Bonoy0328/toothBox/Doc/用户手册/HC32L110管脚功能查询及配置.xlsx

Sheet: 管脚功能查询
 | 筛选条件1 | UART0 | 修改左侧的 筛选条件以 高亮不同的功能 | 筛选条件4 | VCIN0 | 修改左侧的 筛选条件以 高亮不同的功能
 | 筛选条件2 | I2C |  | 筛选条件5 | AIN1
 | 筛选条件3 | LPTIM |  | 筛选条件6 | TIM2
数字功能 |  |  |  |  |  |  |  |  | 模拟功能
Pxx_SEL = 0 | Pxx_SEL = 1 | Pxx_SEL = 2 | Pxx_SEL = 3 | Pxx_SEL = 4 | Pxx_SEL = 5 | Pxx_SEL = 6 | Pxx_SEL = 7
P01 | UART0_RXD | I2C_SDA | UART1_TXD | TIM0_TOG | TIM5_CHB | SPI_SCK | TIM2_EXT |  | XTHI | AIN7 | VCIN7
P02 | UART0_TXD | I2C_SCL | UART1_RXD | TIM0_TOGN | TIM6_CHA | SPI_CS | TIM2_GATE |  | XTHO | AIN8
P03 | PCA_CH3 | SPI_CS | TIM6_CHB | LPTIM_EXT | RTC_1Hz | PCA_ECI | VC0_OUT |  | LVDIN1
P14 | I2C_SCL | TIM2_TOGN | PCA_ECI | ADC_RDY | SPI_CS | UART0_TXD | NC |  | XTLI
P15 | I2C_SDA | TIM2_TOG | TIM4_CHB | LPTIM_GATE | SPI_SCK | UART0_RXD | LVD_OUT |  | XTLO
P23 | TIM6_CHA | TIM4_CHB | TIM4_CHA | PCA_CH0 | SPI_MISO | UART1_TXD | IR_OUT |  | LVDIN2 | VCIN0
P24 | TIM4_CHB | TIM5_CHB | HCLK_OUT | PCA_CH1 | SPI_MOSI | UART1_RXD | VC1_OUT |  | AIN0
P25 | SPI_SCK | PCA_CH0 | TIM5_CHA | LVD_OUT | LPUART_RXD | I2C_SDA | TIM1_GATE |  | LVDIN3 | VCIN1
P26 | SPI_MOSI | TIM4_CHA | TIM5_CHB | PCA_CH2 | LPUART_TXD | I2C_SCL | TIM1_EXT |  | AIN1
P27/SWDIO | SPI_MISO | TIM5_CHA | TIM6_CHA | PCA_CH3 | UART0_RXD | RCH_OUT | XTH_OUT
P31/SWCLK | LPTIM_TOG | PCA_ECI | PCLK_OUT | VC0_OUT | UART0_TXD | RCL_OUT | HCLK_OUT
P32 | LPTIM_TOGN | PCA_CH2 | TIM6_CHB | VC1_OUT | UART1_TXD | PCA_CH4 | RTC_1Hz |  | AIN2 | VCIN2
P33 | LPUART_RXD | PCA_CH1 | TIM5_CHB | PCA_ECI | UART1_RXD | XTL_OUT | TIM1_TOGN |  | AIN3 | VCIN3
P34 | PCA_CH0 | LPUART_TXD | TIM5_CHA | TIM0_EXT | TIM4_CHA | RTC_1Hz | TIM1_TOG |  | AIN4 | VCIN4
P35 | UART1_TXD | TIM6_CHB | UART0_TXD | TIM0_GATE | TIM4_CHB | SPI_MISO | I2C_SDA |  | AIN5 | VCIN5
P36 | UART1_RXD | TIM6_CHA | UART0_RXD | PCA_CH4 | TIM5_CHA | SPI_MOSI | I2C_SCL |  | AIN6 | VCIN6 | ADC_VREF
AIN4 | AIN5 | AIN6 | AIN7 | AIN8 | LVDIN1 | XTLO | XTLI | LVDIN2 | AIN0 | LVDIN3 | AIN1 |  |  | AIN2 | AIN3
VCIN4 | VCIN5 | ADC_VREF | XTHI | XTHO |  |  |  | VCIN0 |  | VCIN1 |  |  |  | VCIN2 | VCIN3
 |  | VCIN6 | VCIN7
P34 | P35 | P36 | P01 | P02 | P03 | P15 | P14 | P23 | P24 | P25 | P26 | P27/SWDIO | P31/SWCLK | P32 | P33
PCA_CH0 | UART1_TXD | UART1_RXD | UART0_RXD | UART0_TXD | PCA_CH3 | I2C_SDA | I2C_SCL | TIM6_CHA | TIM4_CHB | SPI_SCK | SPI_MOSI | SPI_MISO | LPTIM_TOG | LPTIM_TOGN | LPUART_RXD
LPUART_TXD | TIM6_CHB | TIM6_CHA | I2C_SDA | I2C_SCL | SPI_CS | TIM2_TOG | TIM2_TOGN | TIM4_CHB | TIM5_CHB | PCA_CH0 | TIM4_CHA | TIM5_CHA | PCA_ECI | PCA_CH2 | PCA_CH1
TIM5_CHA | UART0_TXD | UART0_RXD | UART1_TXD | UART1_RXD | TIM6_CHB | TIM4_CHB | PCA_ECI | TIM4_CHA | HCLK_OUT | TIM5_CHA | TIM5_CHB | TIM6_CHA | PCLK_OUT | TIM6_CHB | TIM5_CHB
TIM0_EXT | TIM0_GATE | PCA_CH4 | TIM0_TOG | TIM0_TOGN | LPTIM_EXT | LPTIM_GATE | ADC_RDY | PCA_CH0 | PCA_CH1 | LVD_OUT | PCA_CH2 | PCA_CH3 | VC0_OUT | VC1_OUT | PCA_ECI
TIM4_CHA | TIM4_CHB | TIM5_CHA | TIM5_CHB | TIM6_CHA | RTC_1Hz | SPI_SCK | SPI_CS | SPI_MISO | SPI_MOSI | LPUART_RXD | LPUART_TXD | UART0_RXD | UART0_TXD | UART1_TXD | UART1_RXD
RTC_1Hz | SPI_MISO | SPI_MOSI | SPI_SCK | SPI_CS | PCA_ECI | UART0_RXD | UART0_TXD | UART1_TXD | UART1_RXD | I2C_SDA | I2C_SCL | RCH_OUT | RCL_OUT | PCA_CH4 | XTL_OUT
TIM1_TOG | I2C_SDA | I2C_SCL | TIM2_EXT | TIM2_GATE | VC0_OUT | LVD_OUT | NC | IR_OUT | VC1_OUT | TIM1_GATE | TIM1_EXT | XTH_OUT | HCLK_OUT | RTC_1Hz | TIM1_TOGN

Sheet: 管脚功能配置
管脚名称 | 管脚功能 | 输入输出 | 输出类型 | 输出初值 | 上拉下拉 | 管脚初始化源码
P01 | GPIO | 输入 | 推挽 | 0 | 上拉 | M0P_GPIO->P0ADS = 0x0000; | M0P_GPIO->P2ADS = 0x0000;
P02 | GPIO | 输入 | 推挽 | 0 | 上拉 | M0P_GPIO->P0PU = 0x000E; | M0P_GPIO->P2PU = 0x00F8;
P03 | GPIO | 输入 | 推挽 | 0 | 上拉 | M0P_GPIO->P0PD = 0x0000; | M0P_GPIO->P2PD = 0x0000;
P14 | GPIO | 输入 | 推挽 | 0 | 上拉 | M0P_GPIO->P0OD = 0x0000; | M0P_GPIO->P2OD = 0x0000;
P15 | GPIO | 输入 | 推挽 | 0 | 上拉 | M0P_GPIO->P0OUT = 0x0000; | M0P_GPIO->P2OUT = 0x0000;
P23 | GPIO | 输入 | 推挽 | 0 | 上拉 | M0P_GPIO->P0DIR = 0x000E; | M0P_GPIO->P2DIR = 0x00F8;
P24 | GPIO | 输入 | 推挽 | 0 | 上拉 | //P01 = GPIO | //P23 = GPIO
P25 | GPIO | 输入 | 推挽 | 0 | 上拉 | //P02 = GPIO | //P24 = GPIO
P26 | GPIO | 输入 | 推挽 | 0 | 上拉 | //P03 = GPIO | //P25 = GPIO
P27 | SWDIO | NA | NA | NA | 上拉 |  | //P26 = GPIO
P31 | SWDCK | NA | NA | NA | 上拉 |  | //P27 = GPIO
P32 | GPIO | 输入 | 推挽 | 0 | 上拉
P33 | GPIO | 输入 | 推挽 | 0 | 上拉 | M0P_GPIO->P1ADS = 0x0000; | M0P_GPIO->P3ADS = 0x0000;
P34 | GPIO | 输入 | 推挽 | 0 | 上拉 | M0P_GPIO->P1PU = 0x0030; | M0P_GPIO->P3PU = 0x007E;
P35 | GPIO | 输入 | 推挽 | 0 | 上拉 | M0P_GPIO->P1PD = 0x0000; | M0P_GPIO->P3PD = 0x0000;
P36 | GPIO | 输入 | 推挽 | 0 | 上拉 | M0P_GPIO->P1OD = 0x0000; | M0P_GPIO->P3OD = 0x0000;
 |  |  |  |  |  | M0P_GPIO->P1OUT = 0x0000; | M0P_GPIO->P3OUT = 0x0000;
 |  |  |  |  |  | M0P_GPIO->P1DIR = 0x0030; | M0P_GPIO->P3DIR = 0x007E;
 |  |  |  |  |  | //P14 = GPIO | //P31 = GPIO
 |  |  |  |  |  | //P15 = GPIO | //P32 = GPIO
 |  |  |  |  |  |  | //P33 = GPIO
 |  |  |  |  |  |  | //P34 = GPIO
 |  |  |  |  |  |  | //P35 = GPIO
 |  |  |  |  |  |  | //P36 = GPIO
