Bonoy0328/toothBox/(list of files, drawings)

Other design files:
Hal/toothpickBox(1).~(4).SchDoc
