Bonoy0328/toothBox/Prj/driver/inc/gpio.h

/*******************************************************************************
* Copyright (C) 2017, Huada Semiconductor Co.,Ltd All rights reserved.
*
* This software is owned and published by:
* Huada Semiconductor Co.,Ltd ("HDSC").
*
* BY DOWNLOADING, INSTALLING OR USING THIS SOFTWARE, YOU AGREE TO BE BOUND
* BY ALL THE TERMS AND CONDITIONS OF THIS AGREEMENT.
*
* This software contains source code for use with HDSC
* components. This software is licensed by HDSC to be adapted only
* for use in systems utilizing HDSC components. HDSC shall not be
* responsible for misuse or illegal use of this software for devices not
* supported herein. HDSC is providing this software "AS IS" and will
* not be responsible for issues arising from incorrect user implementation
* of the software.
*
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
* This software may be replicated in part or whole for the licensed use,
* with the restriction that this Disclaimer and Copyright notice must be
* included with each copy of this software, whether used in part or whole,
* at all times.
*/
/******************************************************************************/
/** \file gpio.h
 **
 ** GPIO driver
 ** @link GPIO Group Some description @endlink
 **
 **   - 2017-05-04
 **
 ******************************************************************************/

#ifndef __GPIO_H__
#define __GPIO_H__

/*******************************************************************************
 * Include files
 ******************************************************************************/
#include "ddl.h"
#include "interrupts_hc32l110.h"

/* C binding of definitions if building with C++ compiler */
#ifdef __cplusplus
extern "C"
{
#endif

/**
 *******************************************************************************
 ** \defgroup GpioGroup General Purpose I/O (GPIO)
 **
 **
 ******************************************************************************/
//@{
#define GPIO_GPSZ       (0x40u)

/*******************************************************************************
 * Global type definitions
 ******************************************************************************/

/**
 *******************************************************************************
 ** \brief GPIO输入输出方向
 ******************************************************************************/
typedef enum en_gpio_dir
{
    GpioDirOut,                 ///< GPIO 输出
    GpioDirIn,                  ///< GPIO 输入
}en_gpio_dir_t;


/**
 *******************************************************************************
 ** \brief GPIO中断触发方式
 ******************************************************************************/
typedef enum en_gpio_irqtype
{
    GpioIrqHigh     = 1 << 0,   ///< GPIO高电平触发
    GpioIrqLow      = 1 << 1,   ///< GPIO低电平触发
    GpioIrqRising   = 1 << 2,   ///< GPIO上升沿触发
    GpioIrqFalling  = 1 << 3,   ///< GPIO下降沿触发
}en_gpio_irqtype_t;

/**
 *******************************************************************************
 ** \brief GPIO附加功能
 ******************************************************************************/
typedef enum en_gpio_ctrlext
{
    GpioCtrlIESEL,              ///< >0:    deep sleep
                                ///< =0:    active sleep
    GpioCtrlIRPOL,              ///< >0:    reverse output
                                ///< =0:    normal output
    GpioCtrlHclkEn,             ///< >0:    output enable
                                ///< =0     output disable
    GpioCtrlPclkEn,             ///< >0:    output enable
                                ///< =0     output disable
    GpioCtrlHclkSel,            ///< div value
    GpioCtrlPclkSel,            ///< div value
}en_gpio_ctrlext_t;

/**
 *******************************************************************************
 ** \brief GPIO SSN 信号源枚举
 ******************************************************************************/
typedef enum en_gpio_ctrl1src
{
    GpioCtrl1SrcP35 = 0x1,      ///< P35
    GpioCtrl1SrcP36 = 0x2,      ///< P36
    GpioCtrl1SrcP01 = 0x3,      ///< P01
    GpioCtrl1SrcP02 = 0x4,      ///< P02
    GpioCtrl1SrcP03 = 0x5,      ///< P03
    GpioCtrl1SrcP15 = 0x6,      ///< P15
    GpioCtrl1SrcP14 = 0x7,      ///< P14
    GpioCtrl1SrcP23 = 0x8,      ///< P23
    GpioCtrl1SrcP24 = 0x9,      ///< P24
    GpioCtrl1SrcP25 = 0xA,      ///< P25
    GpioCtrl1SrcP26 = 0xB,      ///< P26
    GpioCtrl1SrcP27 = 0xC,      ///< P27
    GpioCtrl1SrcP31 = 0xD,      ///< P31
    GpioCtrl1SrcP32 = 0xE,      ///< P32
    GpioCtrl1SrcP33 = 0xF,      ///< P33

}en_gpio_ctrl1src_t;


/**
 *******************************************************************************
 ** \brief GPIO PCA 捕获通道x信号来源选择
 ******************************************************************************/
typedef enum en_gpio_target
{
    GpioSignalCAP4,     ///< CAP4
    GpioSignalCAP3,     ///< CAP3
    GpioSignalCAP2,     ///< CAP2
    GpioSignalCAP1,     ///< CAP1
    GpioSignalCAP0,     ///< CAP0
    GpioSignalTm6A,     ///< Tm6A
    GpioSignalTm5A,     ///< Tm5A
    GpioSignalTm4A,     ///< Tm4A
    GpioSignalTm6B,     ///< Tm6B
    GpioSignalTm5B,     ///< Tm5B
    GpioSignalTm4B,     ///< Tm4B
    GpioSignalTm3,      ///< Tm3
    GpioSignalTm2,      ///< Tm2
    GpioSignalTm1,      ///< Tm1
    GpioSignalTm0,      ///< Tm0
}en_gpio_target_t;

/**
 *******************************************************************************
 ** \brief GPIO Timer信号来源选择
 ******************************************************************************/
typedef enum en_gpio_timex_in
{
    GpioTMxIn = 0,          ///< TMx
    GpioPcaCapxIn = 0,      ///< PcaCapx
    GpioUart0RxdIn = 1,     ///< Uart0Rxd
    GpioUart1RxdIn = 2,     ///< Uart1Rxd
    GpioUart2RxdIn = 3,     ///< Uart2Rxd
}en_gpio_timex_in_t;


/*******************************************************************************
 * Global definitions
 ******************************************************************************/

///< GPIO 模拟功能选择
en_result_t Gpio_SetAnalog(uint8_t u8Port, uint8_t u8Pin, boolean_t bFlag);

///< GPIO IO功能初始化
en_result_t Gpio_InitIO(uint8_t u8Port, uint8_t u8Pin,
                        en_gpio_dir_t enDir);

en_result_t Gpio_InitIOExt(uint8_t u8Port, uint8_t u8Pin,
                        en_gpio_dir_t enDir,
                        boolean_t bPullup,
                        boolean_t bPulldown,
                        boolean_t bOdr,
                        boolean_t bDrive);

///< GPIO IO输出输入电平
void Gpio_SetIO(uint8_t u8Port, uint8_t u8Pin,boolean_t bVal);
boolean_t Gpio_GetIO(uint8_t u8Port, uint8_t u8Pin);

///< GPIO 中断控制使能
en_result_t Gpio_EnableIrq(uint8_t u8Port,
                           uint8_t u8Pin,
                           en_gpio_irqtype_t enType);

en_result_t Gpio_DisableIrq(uint8_t u8Port,
                            uint8_t u8Pin,
                            en_gpio_irqtype_t enType);

boolean_t Gpio_GetIrqStat(uint8_t u8Port,uint8_t u8Pin);
en_result_t Gpio_ClearIrq(uint8_t u8Port,uint8_t u8Pin);

///< GPIO 附加功能函数
en_result_t Gpio_SetCtrlExt(en_gpio_ctrlext_t enFunc, uint8_t u8val);
en_result_t Gpio_SetSsnSel(en_gpio_ctrl1src_t enSrc);
en_result_t Gpio_SetExtClkSel(en_gpio_ctrl1src_t enSrc);
en_result_t Gpio_SetSignalSource(en_gpio_target_t enTarget, en_gpio_timex_in_t enType);

/*
    GPIO PIN功能配置设置宏定义
*/
#define Gpio_SetFunc_UART0_RXD_P01()          do{\
                                                M0P_GPIO->P0ADS_f.P01 = 0;\
                                                M0P_GPIO->P01_SEL_f.SEL = 1;\
                                                M0P_GPIO->P0DIR_f.P01 = 1;\
                                            }while(0);

#define Gpio_SetFunc_I2C_SDA_P01()           do{\
                                                M0P_GPIO->P0ADS_f.P01 = 0;\
                                                M0P_GPIO->P01_SEL_f.SEL = 2;\
                                                M0P_GPIO->P0DIR_f.P01 = 0;\
                                            }while(0);

#define Gpio_SetFunc_UART1_TXD_P01()          do{\
                                                M0P_GPIO->P0ADS_f.P01 = 0;\
                                                M0P_GPIO->P01_SEL_f.SEL = 3;\
                                                M0P_GPIO->P0DIR_f.P01 = 0;\
                                            }while(0);

#define Gpio_SetFunc_TIM0_TOG_P01()        do{\
                                                M0P_GPIO->P0ADS_f.P01 = 0;\
                                                M0P_GPIO->P01_SEL_f.SEL = 4;\
                                                M0P_GPIO->P0DIR_f.P01 = 0;\
                                            }while(0);

#define Gpio_SetFunc_TIM5_CHB_P01()              do{\
                                                M0P_GPIO->P0ADS_f.P01 = 0;\
                                                M0P_GPIO->P01_SEL_f.SEL = 5;\
                                                M0P_GPIO->P0DIR_f.P01 = 0;\
                                            }while(0);

#define Gpio_SetFunc_SPI_SCK_P01()           do{\
                                                M0P_GPIO->P0ADS_f.P01 = 0;\
                                                M0P_GPIO->P01_SEL_f.SEL = 6;\
                                                M0P_GPIO->P0DIR_f.P01 = 0;\
                                            }while(0);

#define Gpio_SetFunc_TIM2_EXT_P01()             do{\
                                                M0P_GPIO->P0ADS_f.P01 = 0;\
                                                M0P_GPIO->P01_SEL_f.SEL = 7;\
                                                M0P_GPIO->P0DIR_f.P01 = 1;\
                                            }while(0);

#define Gpio_SetFunc_UART0_TXD_P02()          do{\
                                                M0P_GPIO->P0ADS_f.P02 = 0;\
                                                M0P_GPIO->P02_SEL_f.SEL = 1;\
                                                M0P_GPIO->P0DIR_f.P02 = 0;\
                                            }while(0);

#define Gpio_SetFunc_I2C_SCL_P02()           do{\
                                                M0P_GPIO->P0ADS_f.P02 = 0;\
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
 ******************************************************************************/

/******************************************************************************
 * Global variable definitions ('extern')
 ******************************************************************************/

/******************************************************************************
  Global function prototypes (definition in C source)
*******************************************************************************/


//@} // GpioGroup

#ifdef __cplusplus
}
#endif

#endif /* __GPIO_H__ */
/******************************************************************************
 * EOF (not truncated)
 ******************************************************************************/
