Bonoy0328/toothBox/Prj/driver/src/bt.c

/******************************************************************************
*Copyright(C)2017, Huada Semiconductor Co.,Ltd All rights reserved.
*
* This software is owned and published by:
* Huada Semiconductor Co.,Ltd("HDSC").
*
* BY DOWNLOADING, INSTALLING OR USING THIS SOFTWARE, YOU AGREE TO BE BOUND
* BY ALL THE TERMS AND CONDITIONS OF THIS AGREEMENT.
*
* This software contains source code for use with HDSC
* components. This software is licensed by HDSC to be adapted only
* for use in systems utilizing HDSC components. HDSC shall not be
* responsible for misuse or illegal use of this software for devices not
* supported herein. HDSC is providing this software "AS IS" and will
* not be responsible for issues arising from incorrect user implementation
* of the software.
*
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
* This software may be replicated in part or whole for the licensed use,
* with the restriction that this Disclaimer and Copyright notice must be
* included with each copy of this software, whether used in part or whole,
* at all times.
*/

/** \file bt.c
 **
 ** Common API of base timer.
 ** @link btGroup Some description @endlink
 **
 **   - 2017-05-16
 **
 ******************************************************************************/

/*******************************************************************************
 * Include files
 ******************************************************************************/
#include "bt.h"
/**
 *******************************************************************************
 ** \addtogroup BtGroup
 ******************************************************************************/
//@{

/*******************************************************************************
 * Local pre-processor symbols/macros ('#define')
 ******************************************************************************/
#define IS_VALID_TIM(x)         (TIM0 == (x) ||\
                                 TIM1 == (x) ||\
                                 TIM2 == (x))

/*******************************************************************************
 * Global variable definitions (declared in header file with 'extern')
 ******************************************************************************/

/*******************************************************************************
 * Local type definitions ('typedef')
 ******************************************************************************/

/*******************************************************************************
 * Local variable definitions ('static')
 ******************************************************************************/
static func_ptr_t pfnTim0Callback = NULL;
static func_ptr_t pfnTim1Callback = NULL;
static func_ptr_t pfnTim2Callback = NULL;
/*******************************************************************************
 * Local function prototypes ('static')
 ******************************************************************************/


/*******************************************************************************
 * Function implementation - global ('extern') and local ('static')
 ******************************************************************************/
/**
 *****************************************************************************
 ** \brief Base Timer 中断标志获取
 **
 **
 ** \param [in]  enUnit           Timer通道选择（TIM0、TIM1、TIM2）
 ** 
 ** \retval TRUE or FALSE                                      
 *****************************************************************************/
boolean_t Bt_GetIntFlag(en_bt_unit_t enUnit)
{
    boolean_t bRetVal = FALSE;
  
    ASSERT(IS_VALID_TIM(enUnit));
    
    switch (enUnit)
    {
        case TIM0:
            bRetVal = M0P_BT0->IFR_f.TF ? TRUE : FALSE;
            break;
        case TIM1:
            bRetVal = M0P_BT1->IFR_f.TF ? TRUE : FALSE;
            break;
        case TIM2:
            bRetVal = M0P_BT2->IFR_f.TF ? TRUE : FALSE;
            break;
        default:
            bRetVal = FALSE;
            break;
    }
    
    return bRetVal;
}

/**
 *****************************************************************************
 ** \brief Base Timer 中断标志清除
 **
 **
 ** \param [in]  enUnit           Timer通道选择（TIM0、TIM1、TIM2）
 ** 
 ** \retval Ok or Error                                      
 *****************************************************************************/
en_result_t Bt_ClearIntFlag(en_bt_unit_t enUnit)
{
    en_result_t enResult = Ok;
  
    ASSERT(IS_VALID_TIM(enUnit));
    
    switch (enUnit)
    {
        case TIM0:
            M0P_BT0->ICLR_f.TFC = FALSE;
            break;
        case TIM1:
            M0P_BT1->ICLR_f.TFC = FALSE;;
            break;
        case TIM2:
            M0P_BT2->ICLR_f.TFC = FALSE;;
            break;
        default:
            enResult = Error;
            break;
    }
    
    return enResult;
}

/**
 *****************************************************************************
 ** \brief Base Timer 中断使能
 **
 **
 ** \param [in]  enUnit           Timer通道选择（TIM0、TIM1、TIM2）
 ** 
 ** \retval Ok or Error                                      
 *****************************************************************************/
en_result_t Bt_EnableIrq (en_bt_unit_t enUnit)
{
    en_result_t enResult = Ok;
  
    ASSERT(IS_VALID_TIM(enUnit));
    
    switch (enUnit)
    {
        case TIM0:
            M0P_BT0->CR_f.IE = TRUE;
            break;
        case TIM1:
            M0P_BT1->CR_f.IE = TRUE;
            break;
        case TIM2:
            M0P_BT2->CR_f.IE = TRUE;
            break;
        default:
            enResult = Error;
            break;
    }
    
    return enResult;
}

/**
 *****************************************************************************
 ** \brief Base Timer 中断禁止
 **
 **
 ** \param [in]  enUnit           Timer通道选择（TIM0、TIM1、TIM2）
 ** 
 ** \retval Ok or Error                                      
 *****************************************************************************/
en_result_t Bt_DisableIrq(en_bt_unit_t enUnit)
{
    en_result_t enResult = Ok;
  
    ASSERT(IS_VALID_TIM(enUnit));
    
    switch (enUnit)
    {
        case TIM0:
            M0P_BT0->CR_f.IE = FALSE;
            break;
        case TIM1:
            M0P_BT1->CR_f.IE = FALSE;
            break;
        case TIM2:
            M0P_BT2->CR_f.IE = FALSE;
            break;
        default:
            enResult = Error;
            break;
    }
    
    return enResult;
}

/**
 *****************************************************************************
 ** \brief Base Timer 中断服务函数
 **
 **
 ** \param [in]  u8Param           Timer通道选择（0 - TIM0、1 - TIM1、2 - TIM2）
 ** 
 ** \retval NULL                                     
 *****************************************************************************/
void Tim_IRQHandler(uint8_t u8Param)
{  
    switch (u8Param)
    {
        case 0:
            pfnTim0Callback();
            break;
        case 1:
            pfnTim1Callback();
            break;
        case 2:
            pfnTim2Callback();
            break;
        default:
            ;
            break;       
    }
}



/**
 *****************************************************************************
 ** \brief Base Timer 初始化配置
 **
 **
 ** \param [in]  enUnit           Timer通道选择（TIM0、TIM1、TIM2）
 ** \param [in]  pstcConfig       初始化配置结构体指针
 ** 
 ** \retval Ok or Error                                      
 *****************************************************************************/
en_result_t Bt_Init(en_bt_unit_t enUnit, stc_bt_config_t* pstcConfig)
{
    en_result_t enResult = Ok;
  
    ASSERT(IS_VALID_TIM(enUnit));
    
    switch (enUnit)
    {
        case TIM0:
            {
                M0P_BT0->CR_f.GATE_P = pstcConfig->enGateP;
                M0P_BT0->CR_f.GATE   = pstcConfig->enGate;
                M0P_BT0->CR_f.PRS    = pstcConfig->enPRS;
                M0P_BT0->CR_f.TOG_EN = pstcConfig->enTog;
                M0P_BT0->CR_f.CT     = pstcConfig->enCT;
                M0P_BT0->CR_f.MD     = pstcConfig->enMD; 
                
                pfnTim0Callback      = pstcConfig->pfnTim0Cb;
            }
            break;
        case TIM1:
            {
                M0P_BT1->CR_f.GATE_P = pstcConfig->enGateP;
                M0P_BT1->CR_f.GATE   = pstcConfig->enGate;
                M0P_BT1->CR_f.PRS    = pstcConfig->enPRS;
                M0P_BT1->CR_f.TOG_EN = pstcConfig->enTog;
                M0P_BT1->CR_f.CT     = pstcConfig->enCT;
                M0P_BT1->CR_f.MD     = pstcConfig->enMD;
                
                pfnTim1Callback      = pstcConfig->pfnTim1Cb;
            }
            break;
        case TIM2:
            {
                M0P_BT2->CR_f.GATE_P = pstcConfig->enGateP;
                M0P_BT2->CR_f.GATE   = pstcConfig->enGate;
                M0P_BT2->CR_f.PRS    = pstcConfig->enPRS;
                M0P_BT2->CR_f.TOG_EN = pstcConfig->enTog;
                M0P_BT2->CR_f.CT     = pstcConfig->enCT;
                M0P_BT2->CR_f.MD     = pstcConfig->enMD; 
                
                pfnTim2Callback      = pstcConfig->pfnTim2Cb;
            }
            break;
        default:
            enResult = Error;
            break;
    }
    
    return enResult;
}

/**
 *****************************************************************************
 ** \brief Base Timer 启动运行
 **
 **
 ** \param [in]  enUnit           Timer通道选择（TIM0、TIM1、TIM2）
 ** 
 ** \retval Ok or Error                                      
 *****************************************************************************/
en_result_t Bt_Run(en_bt_unit_t enUnit)
{
    en_result_t enResult = Ok;
  
    ASSERT(IS_VALID_TIM(enUnit));
    
    switch (enUnit)
    {
        case TIM0:
            M0P_BT0->CR_f.TR = TRUE;
            break;
        case TIM1:
            M0P_BT1->CR_f.TR = TRUE;
            break;
        case TIM2:
            M0P_BT2->CR_f.TR = TRUE;
            break;
        default:
            enResult = Error;
            break;
    }
    
    return enResult;    
}

/**
 *****************************************************************************
 ** \brief Base Timer 停止运行
 **
 **
 ** \param [in]  enUnit           Timer通道选择（TIM0、TIM1、TIM2）
 ** 
 ** \retval Ok or Error                                      
 *****************************************************************************/
en_result_t Bt_Stop(en_bt_unit_t enUnit)
{
    en_result_t enResult = Ok;
  
    ASSERT(IS_VALID_TIM(enUnit));
    
    switch (enUnit)
    {
        case TIM0:
            M0P_BT0->CR_f.TR = FALSE;
            break;
        case TIM1:
            M0P_BT1->CR_f.TR = FALSE;
            break;
        case TIM2:
            M0P_BT2->CR_f.TR = FALSE;
            break;
        default:
            enResult = Error;
            break;
    }
    
    return enResult; 
}

/**
 *****************************************************************************
 ** \brief Base Timer 重载值设置
 **
 **
 ** \param [in]  enUnit           Timer通道选择（TIM0、TIM1、TIM2）
 ** \param [in]  u16Data          16bits重载值
 ** 
 ** \retval Ok or Error                                      
 *****************************************************************************/
en_result_t Bt_ARRSet(en_bt_unit_t enUnit, uint16_t u16Data)
{
    en_result_t enResult = Ok;
  
    ASSERT(IS_VALID_TIM(enUnit));
    
    switch (enUnit)
    {
        case TIM0:
            M0P_BT0->ARR_f.ARR = u16Data;
            break;
        case TIM1:
            M0P_BT1->ARR_f.ARR = u16Data;
            break;
        case TIM2:
            M0P_BT2->ARR_f.ARR = u16Data;
            break;
        default:
            enResult = Error;
            break;
    }
    
    return enResult; 
}

/**
 *****************************************************************************
 ** \brief Base Timer 16位计数器初值设置
 **
 **
 ** \param [in]  enUnit           Timer通道选择（TIM0、TIM1、TIM2）
 ** \param [in]  u16Data          16位初值
 ** 
 ** \retval Ok or Error                                      
 *****************************************************************************/
en_result_t Bt_Cnt16Set(en_bt_unit_t enUnit, uint16_t u16Data)
{
    en_result_t enResult = Ok;
  
    ASSERT(IS_VALID_TIM(enUnit));
    
    switch (enUnit)
    {
        case TIM0:
            M0P_BT0->CNT_f.CNT = u16Data;
            break;
        case TIM1:
            M0P_BT1->CNT_f.CNT = u16Data;
            break;
        case TIM2:
            M0P_BT2->CNT_f.CNT = u16Data;
            break;
        default:
            enResult = Error;
            break;
    }
    
    return enResult; 
}

/**
 *****************************************************************************
 ** \brief Base Timer 16位计数值获取
 **
 **
 ** \param [in]  enUnit           Timer通道选择（TIM0、TIM1、TIM2）
 ** 
 ** \retval 16bits计数值                                      
 *****************************************************************************/
uint16_t Bt_Cnt16Get(en_bt_unit_t enUnit)
{
    uint16_t    u16CntData = 0;
  
    ASSERT(IS_VALID_TIM(enUnit));
    
    switch (enUnit)
    {
        case TIM0:
            u16CntData = M0P_BT0->CNT_f.CNT;
            break;
        case TIM1:
            u16CntData = M0P_BT1->CNT_f.CNT;
            break;
        case TIM2:
            u16CntData = M0P_BT2->CNT_f.CNT;
            break;
        default:
            u16CntData = 0;
            break;
    }
    
    return u16CntData; 
}

/**
 *****************************************************************************
 ** \brief Base Timer 32位计数器初值设置
 **
 **
 ** \param [in]  enUnit           Timer通道选择（TIM0、TIM1、TIM2）
 ** \param [in]  u32Data          32位初值
 ** 
 ** \retval Ok or Error                                      
 *****************************************************************************/
en_result_t Bt_Cnt32Set(en_bt_unit_t enUnit, uint32_t u32Data)
{
    en_result_t enResult = Ok;
  
    ASSERT(IS_VALID_TIM(enUnit));
    
    switch (enUnit)
    {
        case TIM0:
            M0P_BT0->CNT32_f.CNT32 = u32Data;
            break;
        case TIM1:
            M0P_BT1->CNT32_f.CNT32 = u32Data;
            break;
        case TIM2:
            M0P_BT2->CNT32_f.CNT32 = u32Data;
            break;
        default:
            enResult = Error;
            break;
    }
    
    return enResult; 
}

/**
 *****************************************************************************
 ** \brief Base Timer 32位计数值获取
 **
 **
 ** \param [in]  enUnit           Timer通道选择（TIM0、TIM1、TIM2）
 ** 
 ** \retval 32bits计数值                                      
 *****************************************************************************/
uint32_t Bt_Cnt32Get(en_bt_unit_t enUnit)
{
    uint32_t    u32CntData = 0;
  
    ASSERT(IS_VALID_TIM(enUnit));
    
    switch (enUnit)
    {
        case TIM0:
            u32CntData = M0P_BT0->CNT32_f.CNT32;
            break;
        case TIM1:
            u32CntData = M0P_BT1->CNT32_f.CNT32;
            break;
        case TIM2:
            u32CntData = M0P_BT2->CNT32_f.CNT32;
            break;
        default:
            u32CntData = 0;
            break;
    }
    
    return u32CntData;
}

//@} // BtGroup

/*******************************************************************************
 * EOF (not truncated)
 ******************************************************************************/
