Bonoy0328/toothBox/Prj/driver/src/flash.c

/******************************************************************************
*Copyright(C)2017, Huada Semiconductor Co.,Ltd All rights reserved.
*
* This software is owned and published by:
* Huada Semiconductor Co.,Ltd("HDSC").
*
* BY DOWNLOADING, INSTALLING OR USING THIS SOFTWARE, YOU AGREE TO BE BOUND
* BY ALL THE TERMS AND CONDITIONS OF THIS AGREEMENT.
*
* This software contains source code for use with HDSC
* components. This software is licensed by HDSC to be adapted only
* for use in systems utilizing HDSC components. HDSC shall not be
* responsible for misuse or illegal use of this software for devices not
* supported herein. HDSC is providing this software "AS IS" and will
* not be responsible for issues arising from incorrect user implementation
* of the software.
*
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
* This software may be replicated in part or whole for the licensed use,
* with the restriction that this Disclaimer and Copyright notice must be
* included with each copy of this software, whether used in part or whole,
* at all times.
*/

/** \file flash.c
 **
 ** Common API of flash.
 ** @link flashGroup Some description @endlink
 **
 **   - 2017-05-16
 **
 ******************************************************************************/

/*******************************************************************************
 * Include files
 ******************************************************************************/
#include "flash.h"
/**
 *******************************************************************************
 ** \addtogroup FlashGroup
 ******************************************************************************/
//@{

/*******************************************************************************
 * Local pre-processor symbols/macros ('#define')
 ******************************************************************************/
#define FLASH_END_ADDR              (0x00007FFFu)
#define FLASH_BYPASS()              M0P_FLASH->BYPASS_f.BYSEQ = 0x5A5A;\
                                    M0P_FLASH->BYPASS_f.BYSEQ = 0xA5A5; 
#define FLASH_IE_TRUE               (0x03)
#define FLASH_IE_FALSE              (0x00)   
/*******************************************************************************
 * Global variable definitions (declared in header file with 'extern')
 ******************************************************************************/

/*******************************************************************************
 * Local type definitions ('typedef')
 ******************************************************************************/
/**
 ******************************************************************************
 ** \brief FLASH OP
 ** 
 ** Flash 操作控制数据类型重定义 
 ******************************************************************************/
typedef enum en_flash_op
{
    Read        = 0u,           ///<读配置值
    Program     = 1u,           ///<编程配置值
    SectorErase = 2u,           ///<扇区擦除配置值
    ChipErase   = 3u,           ///<全片擦除配置值
} en_flash_op_t;

/**
 ******************************************************************************
 ** \brief FLASH LOCK
 ** 
 ** Flash 加解锁数据类型重定义 
 ******************************************************************************/
typedef enum en_flash_lock
{
    LockAll   = 0x0000u,      ///<全片加锁  
    UnlockAll = 0xFFFFu,      ///<全片解锁
} en_flash_lock_t;

/**
 ******************************************************************************
 ** \brief FLASH 编程时间参数配置
 ** 
 ** FLASH编程时间参数配置数据类型重定义 (4MHz)
 ******************************************************************************/
typedef enum en_flash_prgtimer
{
    Tnvs      = 32u,
    Tpgs      = 23u,
    Tprog     = 27u,
    Tserase   = 18000u,
    Tmerase   = 140000u,
    Tprcv     = 24u,
    Tsrcv     = 240u,
    Tmrcv     = 1000u,
} en_flash_prgtimer_t;

/*******************************************************************************
 * Local variable definitions ('static')
 ******************************************************************************/

/*******************************************************************************
 * Local function prototypes ('static')
 ******************************************************************************/
static func_ptr_t pfnFlashCallback = NULL;

/*******************************************************************************
 * Function implementation - global ('extern') and local ('static')
 ******************************************************************************/
/**
 *****************************************************************************
 ** \brief Flash中断标志获取
 **
 **
 ** \param [in]  enFlashIntType          Flash中断类型
 ** 
 ** \retval TRUE or FALSE                                      
 *****************************************************************************/
boolean_t Flash_GetIntFlag(en_flash_int_type_t enFlashIntType)
{
    boolean_t bRetVal = FALSE;
    
    switch (enFlashIntType)
    {
        case flash_int0:
            bRetVal = M0P_FLASH->IFR_f.IF0 ? TRUE : FALSE;
            break;
        case flash_int1:
            bRetVal = M0P_FLASH->IFR_f.IF1 ? TRUE : FALSE;
            break;
        default:
            bRetVal = FALSE;
            break;
    }
    
    return bRetVal;
}

/**
 *****************************************************************************
 ** \brief Flash中断标志清除
 **
 **
 ** \param [in]  enFlashIntType          Flash中断类型
 ** 
 ** \retval Ok or Error                                      
 *****************************************************************************/
en_result_t Flash_ClearIntFlag(en_flash_int_type_t enFlashIntType)
{
    en_result_t enResult = Error;

    switch (enFlashIntType)
    {
        case flash_int0:
            FLASH_BYPASS();
            M0P_FLASH->ICLR_f.ICLR0 = FALSE;
            enResult = Ok;
            break;
        case flash_int1:
            FLASH_BYPASS();
            M0P_FLASH->ICLR_f.ICLR1 = FALSE;
            enResult = Ok;
            break;
        default:
            enResult = Error;
            break;
    }

    return enResult;
}

/**
 *****************************************************************************
 ** \brief Flash中断服务函数
 **
 **
 ** \param [in] u8Param        == 0
 **                                      
 *****************************************************************************/
void EfRam_IRQHandler(uint8_t u8Param)
{   
    pfnFlashCallback();
}

/**
 *****************************************************************************
 ** \brief Flash中断使能
 **
 **
 ** \param [in]  enFlashIntType          Flash中断类型
 ** 
 ** \retval Ok or Error                                      
 *****************************************************************************/
en_result_t Flash_EnableIrq (en_flash_int_type_t enFlashIntType)
{
    en_result_t enResult = Error;

    switch (enFlashIntType)
    {
        case flash_int0:
            FLASH_BYPASS();
            M0P_FLASH->CR_f.IE |= 0x01;
            enResult = Ok;
            break;
        case flash_int1:
            FLASH_BYPASS();
            M0P_FLASH->CR_f.IE |= 0x02;
            enResult = Ok;
            break;
        default:
            enResult = Error;
            break;
    }

    return enResult;
}

/**
 *****************************************************************************
 ** \brief Flash中断禁止
 **
 **
 ** \param [in]  enFlashIntType          Flash中断类型
 ** 
 ** \retval Ok or Error                                      
 *****************************************************************************/
en_result_t Flash_DisableIrq(en_flash_int_type_t enFlashIntType)
{
    en_result_t enResult = Error;

    switch (enFlashIntType)
    {
        case flash_int0:
            FLASH_BYPASS();
            M0P_FLASH->CR_f.IE &= ~0x02u;
            enResult = Ok;
            break;
        case flash_int1:
            FLASH_BYPASS();
            M0P_FLASH->CR_f.IE &= ~0x01u;
            enResult = Ok;
            break;
        default:
            enResult = Error;
            break;
    }

    return enResult;
}

/**
 *****************************************************************************
 ** \brief FLASH 中断服务程序及编程时间配置
 **
 ** 该函数用于配置中断服务函数并根据系统时钟配置FLASH编程时间相关寄存器.
 **
 ** \param [in]  pfnFlashCb       Flash中断服务回调函数[void function(void)]
 ** \param [in]  u8FreqCfg        时钟频率配置：
 **                                  0      - (0,4]MHz;
 **                                  1      - (4,8]MHz;
 **                                  2      - (8,16]MHz;
 **                                  3      - (16,32]MHz（该配置会打开读FLASH等待周期）;
 **                                 other   -  无效值                                                  
 ** 
 ** \retval Ok                    操作成功.
 ** \retval ErrorInvalidParameter 参数无效.
 **
 *****************************************************************************/
en_result_t Flash_Init(func_ptr_t pfnFlashCb, uint8_t u8FreqCfg)
{
    en_result_t             enResult = Ok;
    
    if (u8FreqCfg > 3)
    {
        enResult = ErrorInvalidParameter;
        return (enResult);
    }

    //flash时间参数寄存器配置
    FLASH_BYPASS();
    M0P_FLASH->TNVS_f.TNVS       = Tnvs    << u8FreqCfg;
    FLASH_BYPASS();
    M0P_FLASH->TPGS_f.TPGS       = Tpgs    << u8FreqCfg;
    FLASH_BYPASS();
    M0P_FLASH->TPROG_f.TPROG     = Tprog   << u8FreqCfg;
    FLASH_BYPASS();
    M0P_FLASH->TSERASE_f.TSERASE = Tserase << u8FreqCfg;
    FLASH_BYPASS();
    M0P_FLASH->TMERASE_f.TMERASE = Tmerase << u8FreqCfg;
    FLASH_BYPASS();
    M0P_FLASH->TPRCV_f.TPRCV     = Tprcv   << u8FreqCfg;
    FLASH_BYPASS();
    M0P_FLASH->TSRCV_f.TSRCV     = Tsrcv   << u8FreqCfg;
    FLASH_BYPASS();
    M0P_FLASH->TMRCV_f.TMRCV     = Tmrcv   << u8FreqCfg; 
    
    //开启读FLASH等待周期
    if (3 == u8FreqCfg)
    {
        FLASH_BYPASS();
        M0P_FLASH->CR_f.WAIT = TRUE;
    }
    else
    {
        FLASH_BYPASS();    
        M0P_FLASH->CR_f.WAIT = FALSE;
    }
      
    pfnFlashCallback = pfnFlashCb;
    
    return (enResult);
}

/**
 *****************************************************************************
 ** \brief FLASH 字节写
 **
 ** 用于向FLASH写入1字节数据.
 **
 ** \param [in]  u32Addr          Flash地址
 ** \param [in]  u8Data           1字节数据
 ** 
 ** \retval Ok                    写入成功.
 ** \retval ErrorInvalidParameter FLASH地址无效                                
 *****************************************************************************/
en_result_t Flash_WriteByte(uint32_t u32Addr, uint8_t u8Data)
{
    en_result_t             enResult = Ok;    
    
    if (FLASH_END_ADDR < u32Addr)
    {
        enResult = ErrorInvalidParameter;
        return (enResult);
    }
   
    //unlock flash
    FLASH_BYPASS();
    M0P_FLASH->SLOCK_f.SLOCK = UnlockAll;
    
    //busy?
    while (TRUE == M0P_FLASH->CR_f.BUSY)
    {
        ;
    }
    
    //set OP
    FLASH_BYPASS();
    M0P_FLASH->CR_f.OP = Program;
    
    //write data
    *((volatile uint8_t*)u32Addr) = u8Data;
    
    //busy?
    while (TRUE == M0P_FLASH->CR_f.BUSY)
    {
        ;
    }
    
    //lock flash
    FLASH_BYPASS();
    M0P_FLASH->SLOCK_f.SLOCK = LockAll;
    
    return (enResult);
}

/**
 *****************************************************************************
 ** \brief FLASH 半字写
 **
 ** 用于向FLASH写入半字（2字节）数据.
 **
 ** \param [in]  u32Addr         Flash地址
 ** \param [in]  u16Data        半字（2字节）数据
 ** 
 ** \retval Ok                    写入成功.
 ** \retval ErrorInvalidParameter FLASH地址无效                                
 *****************************************************************************/
en_result_t Flash_WriteHalfWord(uint32_t u32Addr, uint16_t u16Data)
{
    en_result_t             enResult = Ok;    
    
    if ((FLASH_END_ADDR < u32Addr) || (u32Addr % 2))
    {
        enResult = ErrorInvalidParameter;
        return (enResult);
    }
   
    //unlock flash
    FLASH_BYPASS();
    M0P_FLASH->SLOCK_f.SLOCK = UnlockAll;
    
    //busy?
    while (TRUE == M0P_FLASH->CR_f.BUSY)
    {
        ;
    }
    
    //set OP
    FLASH_BYPASS();
    M0P_FLASH->CR_f.OP = Program;
    
    //write data
    *((volatile uint16_t*)u32Addr) = u16Data;
    
    //busy?
    while (TRUE == M0P_FLASH->CR_f.BUSY)
    {
        ;
    }
    
    //lock flash
    FLASH_BYPASS();
    M0P_FLASH->SLOCK_f.SLOCK = LockAll;
    
    return (enResult);
}

/**
 *****************************************************************************
 ** \brief FLASH 字写
 **
 ** 用于向FLASH写入1个字的数据.
 **
 ** \param [in]  u32Addr         Flash地址
 ** \param [in]  u32Data         1个字数据
 ** 
 ** \retval Ok                    写入成功.
 ** \retval ErrorInvalidParameter FLASH地址无效                                
 *****************************************************************************/
en_result_t Flash_WriteWord(uint32_t u32Addr, uint32_t u32Data)
{
    en_result_t             enResult = Ok;    
    
    if ((FLASH_END_ADDR < u32Addr) || (u32Addr % 4))
    {
        enResult = ErrorInvalidParameter;
        return (enResult);
    }
   
    //unlock flash
    FLASH_BYPASS();
    M0P_FLASH->SLOCK_f.SLOCK = UnlockAll;
    
    //busy?
    while (TRUE == M0P_FLASH->CR_f.BUSY)
    {
        ;
    }
    
    //set OP
    FLASH_BYPASS();
    M0P_FLASH->CR_f.OP = Program;
    
    //write data
    *((volatile uint32_t*)u32Addr) = u32Data;
    
    //busy?
    while (TRUE == M0P_FLASH->CR_f.BUSY)
    {
        ;
    }
    
    //lock flash
    FLASH_BYPASS();
    M0P_FLASH->SLOCK_f.SLOCK = LockAll;
    
    return (enResult);
}

/**
 *****************************************************************************
 ** \brief FLASH 扇区擦除
 **
 ** FLASH 扇区擦除.
 **
 ** \param [in]  u32SectorAddr    所擦除扇区内的地址
 ** 
 ** \retval Ok                    擦除成功.
 ** \retval ErrorInvalidParameter FLASH地址无效                                
 *****************************************************************************/
en_result_t Flash_SectorErase(uint32_t u32SectorAddr)
{

    en_result_t             enResult = Ok;    
    
    if (FLASH_END_ADDR < u32SectorAddr)
    {
        enResult = ErrorInvalidParameter;
        return (enResult);
    }
   
    //unlock flash
    FLASH_BYPASS();
    M0P_FLASH->SLOCK_f.SLOCK = UnlockAll;
    
    //busy?
    while (TRUE == M0P_FLASH->CR_f.BUSY)
    {
        ;
    }
    
    //set OP
    FLASH_BYPASS();
    M0P_FLASH->CR_f.OP = SectorErase;
    
    //write data
    *((volatile uint8_t*)u32SectorAddr) = 0;
    
    //busy?
    while (TRUE == M0P_FLASH->CR_f.BUSY)
    {
        ;
    }
    
    //lock flash
    FLASH_BYPASS();
    M0P_FLASH->SLOCK_f.SLOCK = LockAll;
    
    return (enResult);
}

/**
 *****************************************************************************
 ** \brief FLASH 全片擦除
 **
 ** FLASH 全片擦除.
 **
 ** 
 ** \retval Ok              擦除成功.
 **                              
 *****************************************************************************/
en_result_t Flash_ChipErase(void)
{

    en_result_t             enResult = Ok;    
   
    //unlock flash
    FLASH_BYPASS();
    M0P_FLASH->SLOCK_f.SLOCK = UnlockAll;
    
    //busy?
    while (TRUE == M0P_FLASH->CR_f.BUSY)
    {
        ;
    }
    
    //set OP
    FLASH_BYPASS();
    M0P_FLASH->CR_f.OP = ChipErase;
    
    //write data
    *((volatile uint8_t*)0) = 0;
    
    //busy?
    while (TRUE == M0P_FLASH->CR_f.BUSY)
    {
        ;
    }
    
    //lock flash
    FLASH_BYPASS();
    M0P_FLASH->SLOCK_f.SLOCK = LockAll;
    
    return (enResult);
}



//@} // FlashGroup

/*******************************************************************************
 * EOF (not truncated)
 ******************************************************************************/
