Bonoy0328/toothBox/Prj/driver/src/vc.c

/******************************************************************************
* Copyright (C) 2017, Huada Semiconductor Co.,Ltd All rights reserved.
*
* This software is owned and published by:
* Huada Semiconductor Co.,Ltd ("HDSC").
*
* BY DOWNLOADING, INSTALLING OR USING THIS SOFTWARE, YOU AGREE TO BE BOUND
* BY ALL THE TERMS AND CONDITIONS OF THIS AGREEMENT.
*
* This software contains source code for use with HDSC
* components. This software is licensed by HDSC to be adapted only
* for use in systems utilizing HDSC components. HDSC shall not be
* responsible for misuse or illegal use of this software for devices not
* supported herein. HDSC is providing this software "AS IS" and will
* not be responsible for issues arising from incorrect user implementation
* of the software.
*
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
* This software may be replicated in part or whole for the licensed use,
* with the restriction that this Disclaimer and Copyright notice must be
* included with each copy of this software, whether used in part or whole,
* at all times.
*/
/******************************************************************************/
/** \file vc.c
 **
 ** voltage comparator driver API.
 ** @link VC Group Some description @endlink
 **
 **   - 2017-06-28 Alex    First Version
 **
 ******************************************************************************/

/******************************************************************************
 * Include files
 ******************************************************************************/
#include "vc.h"

/**
 ******************************************************************************
 ** \addtogroup VcGroup
 ******************************************************************************/
//@{

/******************************************************************************
 * Local pre-processor symbols/macros ('#define')
 ******************************************************************************/
#define IS_VALID_CHANNEL(x)     ( VcChannel0==(x) || VcChannel1 == (x))
#define IS_VALID_STAT(x)        ( VcCmpResult==(x) || VcIntrResult == (x))
#define IS_VALID_DIV(x)         ( (x) <= 64u )

#define IS_VALID_INPUT_P(x)     ( (x) <= VcInPCh7 )

#define IS_VALID_INPUT_N(x)     ( (x) <= AiLdo )

#define IS_VALID_DLY(x)         (   (VcDelay30mv == (x)) ||\
                                    (VcDelay20mv == (x)) ||\
                                    (VcDelay10mv == (x)) ||\
                                    (VcDelayoff == (x)) )

#define IS_VALID_BIAS(x)         (   (VcBias300na == (x)) ||\
                                    (VcBias1200na == (x)) ||\
                                    (VcBias10ua == (x)) ||\
                                    (VcBias20ua == (x)) )

#define IS_VALID_FILTER(x)         ( (x) <= VcFilter28800us )



/******************************************************************************
 * Global variable definitions (declared in header file with 'extern')
 ******************************************************************************/


/******************************************************************************
 * Local type definitions ('typedef')
 ******************************************************************************/

/******************************************************************************
 * Local function prototypes ('static')
 ******************************************************************************/
static en_result_t VcEnableIrq(en_vc_channel_t enChannel, boolean_t bFlag);
static void VcEnableNvic(IRQn_Type enIrqn);
static void VcDisableNvic(IRQn_Type enIrqn);

/******************************************************************************
 * Local variable definitions ('static')
 ******************************************************************************/
static func_ptr_t pfnVc0IrqCb = NULL;
static func_ptr_t pfnVc1IrqCb = NULL;

/*****************************************************************************
 * Function implementation - global ('extern') and local ('static')
 *****************************************************************************/

/**
 * \brief   
 *          指定VC通道中断使能/除能
 *
 * \param   [in]  enChannel  VC通道号
 * \param   [in]  bFlag      使能/除能标志
 *
 * \retval  en_result_t    Ok:  设置成功
 * \retval  en_result_t    ErrorInvalidParameter:  无效参数
 */
static en_result_t VcEnableIrq(en_vc_channel_t enChannel, boolean_t bFlag)
{
    if (VcChannel0 == enChannel)
    {
        if (bFlag)
        {
            VcEnableNvic(VC0_IRQn);
            M0P_VC->VC0_CR_f.IE = 1u;
        }
        else
        {
            M0P_VC->VC0_CR_f.IE = 0u;
            VcDisableNvic(VC0_IRQn);
        }
    }
    else if (VcChannel1 == enChannel)
    {
        if (bFlag)
        {
            VcEnableNvic(VC1_IRQn);
            M0P_VC->VC1_CR_f.IE = 1u;
        }
        else
        {
            M0P_VC->VC1_CR_f.IE = 0u;
            VcDisableNvic(VC1_IRQn);
        }
    }
    else
    {
        return ErrorInvalidParameter;
    }

    return Ok;
}

/**
 * \brief   
 *          使能NVIC中VC中断
 *
 * \param   [in]  enIrqn  中断号
 *
 * \retval  无
 */
static void VcEnableNvic(IRQn_Type enIrqn)
{
    NVIC_ClearPendingIRQ(enIrqn);
    NVIC_EnableIRQ(enIrqn);
    NVIC_SetPriority(enIrqn, DDL_IRQ_LEVEL_DEFAULT);
}

/**
 * \brief   
 *          除能NVIC中VC中断
 *
 * \param   [in]  enIrqn  中断号
 *
 * \retval  无
 */
static void VcDisableNvic(IRQn_Type enIrqn)
{
    NVIC_ClearPendingIRQ(enIrqn);
    NVIC_DisableIRQ(enIrqn);
    NVIC_SetPriority(enIrqn, DDL_IRQ_LEVEL_DEFAULT);
}

/**
 * \brief   
 *          VC中断服务程序
 *
 * \param   [in]  u8Param  VC通道号
 *
 * \retval  无
 */
void Vc_IRQHandler(uint8_t u8Param)
{
    if (0 == u8Param)
    {
        if (TRUE == M0P_VC->IFR_f.VC0_INTF)
        {
            if (NULL != pfnVc0IrqCb)
            {
                pfnVc0IrqCb();
            }
            M0P_VC->IFR_f.VC0_INTF = 0;
        }
    }
    else if (1 == u8Param)
    {
        if (TRUE == M0P_VC->IFR_f.VC1_INTF)
        {
            if (NULL != pfnVc1IrqCb)
            {
                pfnVc1IrqCb();
            }
            M0P_VC->IFR_f.VC1_INTF = 0;
        }
    }
    else
    {
        ;    // just return
    }    
}

/**
 * \brief   
 *          配置VC中断触发方式
 *
 * \param   [in]  enChannel  VC通道号
 * \param   [in]  enSel      中断触发方式选择
 *
 * \retval  en_result_t    Ok:  设置成功
 * \retval  en_result_t    ErrorInvalidParameter:  无效参数
 */
en_result_t Vc_ConfigIrq(en_vc_channel_t enChannel, en_vc_irq_sel_t enSel)
{
    stc_vc_vc0_cr_field_t *stcVcnCr;
    en_result_t enRet = Ok;

    if (VcChannel0 == enChannel)
    {
        stcVcnCr = (stc_vc_vc0_cr_field_t*)&M0P_VC->VC0_CR_f;
    }
    else if (VcChannel1 == enChannel)
    {
        stcVcnCr = (stc_vc_vc0_cr_field_t*)&M0P_VC->VC1_CR_f;
    }
    else
    {
        return ErrorInvalidParameter;
    }

    switch (enSel)
    {
        case VcIrqRise:
            stcVcnCr->RISING = 1u;
            break;
        case VcIrqFall:
            stcVcnCr->FALLING = 1u;
            break;
        case VcIrqHigh:
            stcVcnCr->LEVEL = 1u;
            break;

        default:
            enRet= ErrorInvalidParameter;
            break;
    }

    return enRet;
}

/**
 * \brief   
 *          获取VC状态
 *
 * \param   [in]  enChannel  VC通道号
 * \param   [in]  enStat     VC状态类型
 *
 * \retval  boolean_t  TRUE:   状态为高
 * \retval  boolean_t  FALSE:  状态为低
 */
boolean_t Vc_GetStat(en_vc_channel_t enChannel, en_vc_stat_t enStat)
{
    boolean_t bFlag = FALSE;

    ASSERT( IS_VALID_CHANNEL(enChannel) );
    ASSERT( IS_VALID_STAT(enStat) );

    if (VcChannel0 == enChannel)
    {
        switch (enStat)
        {
            case VcCmpResult:
                bFlag = M0P_VC->IFR_f.VC0_FILTER;
                break;
            case VcIntrResult:
                bFlag = M0P_VC->IFR_f.VC0_INTF;
                break;
            default:
                break;
        }
    }
    else
    {
        switch (enStat)
        {
            case VcCmpResult:
                bFlag = M0P_VC->IFR_f.VC1_FILTER;
                break;
            case VcIntrResult:
                bFlag = M0P_VC->IFR_f.VC1_INTF;
                break;
            default:
                break;
        }
    }

    return bFlag;
}

/**
 * \brief   
 *          清除VC中断标志
 *
 * \param   [in]  enChannel  VC通道号
 *
 * \retval  无
 */
void Vc_ClearIrq(en_vc_channel_t enChannel)
{
    ASSERT( IS_VALID_CHANNEL(enChannel) );

    if (VcChannel0 == enChannel)
    {
        M0P_VC->IFR_f.VC0_INTF = 0u;
    }
    else
    {
        M0P_VC->IFR_f.VC1_INTF = 0u;
    }
}

/**
 * \brief   
 *          指定VC通道中断使能
 *
 * \param   [in]  enChannel  VC通道号
 *
 * \retval  en_result_t    Ok:  设置成功
 * \retval  en_result_t    ErrorInvalidParameter:  无效参数
 */
en_result_t Vc_EnableIrq(en_vc_channel_t enChannel)
{
    return VcEnableIrq(enChannel, TRUE);
}

/**
 * \brief   
 *          指定VC通道中断除能
 *
 * \param   [in]  enChannel  VC通道号
 *
 * \retval  en_result_t    Ok:  设置成功
 *                         ErrorInvalidParameter:  无效参数
 */
en_result_t Vc_DisableIrq(en_vc_channel_t enChannel)
{
    return VcEnableIrq(enChannel, FALSE);
}

/**
 * \brief   
 *          VC模块初始化
 *
 * \param   [in]  pstcGeneralConfig  VC模块配置指针
 *
 * \retval  en_result_t  Ok:  配置成功
 * \retval  en_result_t  ErrorInvalidParameter: 无效参数
 */
en_result_t Vc_GeneralInit(stc_vc_general_config_t *pstcGeneralConfig)
{
    ASSERT(NULL != pstcGeneralConfig);

    M0P_VC->CR_f.DIV_EN = pstcGeneralConfig->bDivEn;
    M0P_VC->CR_f.REF2P5_SEL = pstcGeneralConfig->enDivVref;

    if (pstcGeneralConfig->u8DivVal < 0x40)
    {
        M0P_VC->CR_f.DIV = pstcGeneralConfig->u8DivVal;
    }
    else
    {
        return ErrorInvalidParameter;
    }

    return Ok;
}

/**
 * \brief   
 *          VC模块deinit
 *
 * \param   无
 *
 * \retval  无
 */
void Vc_GeneralDeInit(void)
{
    M0P_VC->CR_f.DIV_EN = 0u;
    M0P_VC->CR_f.DIV = 0x20u;
    M0P_VC->CR_f.REF2P5_SEL = 0u;
}

/**
 * \brief   
 *          VC通道初始化
 *
 * \param   [in]  enChannel  VC通道号
 * \param   [in]  pstcChannelConfig  VC通道配置指针
 *
 * \retval  en_result_t  Ok:  配置成功
 * \retval  en_result_t  ErrorInvalidParameter: 无效参数
 */
en_result_t Vc_ChannelInit(en_vc_channel_t enChannel,
                            stc_vc_channel_config_t *pstcChannelConfig)
{
    //en_result_t enRet = Ok;

    ASSERT(NULL != pstcChannelConfig);
    ASSERT(IS_VALID_INPUT_P(pstcChannelConfig->enVcInPin_P));
    ASSERT(IS_VALID_INPUT_N(pstcChannelConfig->enVcInPin_N));
    ASSERT(IS_VALID_DLY(pstcChannelConfig->enVcCmpDly));
    ASSERT(IS_VALID_BIAS(pstcChannelConfig->enVcBiasCurrent));
    ASSERT(IS_VALID_FILTER(pstcChannelConfig->enVcFilterTime));

    if (VcChannel0 == enChannel)
    {
        M0P_VC->CR_f.VC0_HYS_SEL = pstcChannelConfig->enVcCmpDly;
        M0P_VC->CR_f.VC0_BIAS_SEL = pstcChannelConfig->enVcBiasCurrent;
        M0P_VC->VC0_CR_f.DEBOUNCE_TIME = pstcChannelConfig->enVcFilterTime;
        M0P_VC->VC0_CR_f.P_SEL = pstcChannelConfig->enVcInPin_P;
        M0P_VC->VC0_CR_f.N_SEL = pstcChannelConfig->enVcInPin_N;
        M0P_VC->VC0_OUT_CFG = 1<<pstcChannelConfig->enVcOutConfig;

        switch(pstcChannelConfig->enVcIrqSel)
        {
            case VcIrqRise:
                M0P_VC->VC0_CR_f.LEVEL = 0u;
                M0P_VC->VC0_CR_f.RISING = 1u;
                M0P_VC->VC0_CR_f.FALLING = 0u;
                break;
            case VcIrqFall:
                M0P_VC->VC0_CR_f.LEVEL = 0u;
                M0P_VC->VC0_CR_f.RISING = 0u;
                M0P_VC->VC0_CR_f.FALLING = 1u;
                break;
            case VcIrqHigh:
                M0P_VC->VC0_CR_f.LEVEL = 1u;
                M0P_VC->VC0_CR_f.RISING = 0u;
                M0P_VC->VC0_CR_f.FALLING = 0u;
                break;
            default:
                M0P_VC->VC0_CR_f.LEVEL = 0u;
                M0P_VC->VC0_CR_f.RISING = 0u;
                M0P_VC->VC0_CR_f.FALLING = 0u;
                break;
        }

        pfnVc0IrqCb = pstcChannelConfig->pfnAnalogCmpCb;
    }
    else if (VcChannel1 == enChannel)
    {
        M0P_VC->CR_f.VC1_HYS_SEL = pstcChannelConfig->enVcCmpDly;
        M0P_VC->CR_f.VC1_BIAS_SEL = pstcChannelConfig->enVcBiasCurrent;
        M0P_VC->VC1_CR_f.DEBOUNCE_TIME = pstcChannelConfig->enVcFilterTime;
        M0P_VC->VC1_CR_f.P_SEL = pstcChannelConfig->enVcInPin_P;
        M0P_VC->VC1_CR_f.N_SEL = pstcChannelConfig->enVcInPin_N;
        M0P_VC->VC1_OUT_CFG = 1<<pstcChannelConfig->enVcOutConfig;

        switch(pstcChannelConfig->enVcIrqSel)
        {
            case VcIrqRise:
                M0P_VC->VC1_CR_f.LEVEL = 0u;
                M0P_VC->VC1_CR_f.RISING = 1u;
                M0P_VC->VC1_CR_f.FALLING = 0u;
                break;
            case VcIrqFall:
                M0P_VC->VC1_CR_f.LEVEL = 0u;
                M0P_VC->VC1_CR_f.RISING = 0u;
                M0P_VC->VC1_CR_f.FALLING = 1u;
                break;
            case VcIrqHigh:
                M0P_VC->VC1_CR_f.LEVEL = 1u;
                M0P_VC->VC1_CR_f.RISING = 0u;
                M0P_VC->VC1_CR_f.FALLING = 0u;
                break;
            default:
                M0P_VC->VC1_CR_f.LEVEL = 0u;
                M0P_VC->VC1_CR_f.RISING = 0u;
                M0P_VC->VC1_CR_f.FALLING = 0u;
                break;
        }

        pfnVc1IrqCb = pstcChannelConfig->pfnAnalogCmpCb;
    }
    else
    {
        return ErrorInvalidParameter;
    }

    return Ok;
}

/**
 * \brief   
 *          VC通道Deinit
 *
 * \param   [in]  enChannel  VC通道号
 *
 * \retval  en_result_t  Ok:  配置成功
 * \retval  en_result_t  ErrorInvalidParameter: 无效参数
 */
en_result_t Vc_ChannelDeInit(en_vc_channel_t enChannel)
{
    if (VcChannel0 == enChannel)
    {
        M0P_VC->VC0_CR_f.EN = 0u;
        M0P_VC->CR_f.VC0_HYS_SEL = 0;
        M0P_VC->CR_f.VC0_BIAS_SEL = 0;
        M0P_VC->VC0_CR_f.DEBOUNCE_TIME = 0;
        M0P_VC->VC0_CR_f.P_SEL = 0;
        M0P_VC->VC0_CR_f.N_SEL = 0;
        M0P_VC->VC0_OUT_CFG = 0;
        M0P_VC->VC0_CR_f.LEVEL = 0u;
        M0P_VC->VC0_CR_f.RISING = 0u;
        M0P_VC->VC0_CR_f.FALLING = 0u;
        pfnVc0IrqCb = NULL;
        M0P_VC->VC0_CR_f.IE = 0u;
        VcDisableNvic(VC0_IRQn);
    }
    else if (VcChannel1 == enChannel)
    {
        M0P_VC->VC1_CR_f.EN = 0u;
        M0P_VC->CR_f.VC1_HYS_SEL = 0;
        M0P_VC->CR_f.VC1_BIAS_SEL = 0;
        M0P_VC->VC1_CR_f.DEBOUNCE_TIME = 0;
        M0P_VC->VC1_CR_f.P_SEL = 0;
        M0P_VC->VC1_CR_f.N_SEL = 0;
        M0P_VC->VC1_OUT_CFG = 0;
        M0P_VC->VC1_CR_f.LEVEL = 0u;
        M0P_VC->VC1_CR_f.RISING = 0u;
        M0P_VC->VC1_CR_f.FALLING = 0u;
        pfnVc1IrqCb = NULL;
        M0P_VC->VC1_CR_f.IE = 0u;
        VcDisableNvic(VC1_IRQn);
    }
    else
    {
        return ErrorInvalidParameter;
    }

    return Ok;
}

/**
 * \brief   
 *          VC通道使能
 *
 * \param   [in]  enChannel  VC通道号
 *
 * \retval  en_result_t  Ok:  配置成功
 * \retval  en_result_t  ErrorInvalidParameter: 无效参数
 */
en_result_t Vc_EnableChannel(en_vc_channel_t enChannel)
{
    if (VcChannel0 == enChannel)
    {
        M0P_VC->VC0_CR_f.EN = 1u;
    }
    else if (VcChannel1 == enChannel)
    {
        M0P_VC->VC1_CR_f.EN = 1u;
    }
    else
    {
        return ErrorInvalidParameter;
    }

    return Ok;
}

/**
 * \brief   
 *          VC通道除能
 *
 * \param   [in]  enChannel  VC通道号
 *
 * \retval  en_result_t  Ok:  配置成功
 * \retval  en_result_t  ErrorInvalidParameter: 无效参数
 */
en_result_t Vc_DisableChannel(en_vc_channel_t enChannel)
{
    if (VcChannel0 == enChannel)
    {
        M0P_VC->VC0_CR_f.EN = 0u;
    }
    else if (VcChannel1 == enChannel)
    {
        M0P_VC->VC1_CR_f.EN = 0u;
    }
    else
    {
        return ErrorInvalidParameter;
    }

    return Ok;
}

/**
 * \brief   
 *          VC输出滤波使能
 *
 * \param   [in]  enChannel  VC通道号
 *
 * \retval  en_result_t  Ok:  配置成功
 * \retval  en_result_t  ErrorInvalidParameter: 无效参数
 */
en_result_t Vc_EnableFilter(en_vc_channel_t enChannel)
{
    if (VcChannel0 == enChannel)
    {
        M0P_VC->VC0_CR_f.FLTEN = 1u;
    }
    else if (VcChannel1 == enChannel)
    {
        M0P_VC->VC1_CR_f.FLTEN = 1u;
    }
    else
    {
        return ErrorInvalidParameter;
    }

    return Ok;
}

/**
 * \brief   
 *          VC输出滤波除能
 *
 * \param   [in]  enChannel  VC通道号
 *
 * \retval  en_result_t  Ok:  配置成功
 * \retval  en_result_t  ErrorInvalidParameter: 无效参数
 */
en_result_t Vc_DisableFilter(en_vc_channel_t enChannel)
{
    if (VcChannel0 == enChannel)
    {
        M0P_VC->VC0_CR_f.FLTEN = 0u;
    }
    else if (VcChannel1 == enChannel)
    {
        M0P_VC->VC1_CR_f.FLTEN = 0u;
    }
    else
    {
        return ErrorInvalidParameter;
    }

    return Ok;
}

//@} // VcGroup


/******************************************************************************
 * EOF (not truncated)
 ******************************************************************************/
