Bonoy0328/toothBox/Prj/source/inc/timeTask.h

#ifndef __TIMETASK_H__
#define __TIMETASK_H__

#include "halLayer.h"

void StartTaskScheduler(void);
void MotorCurrentDetectTask(void);
void MotorReverFun(void);
void MainTask(void);

#endif // !__TIMETASK_H__
